pkarcsi55/AI-Assisted-Evaluation-of-Detector-Outputs/Schematic_DETECTOR_2025-05-02.pdf

# LOLIN-Lite-ESP32 Bat+ 27 Bat- 28

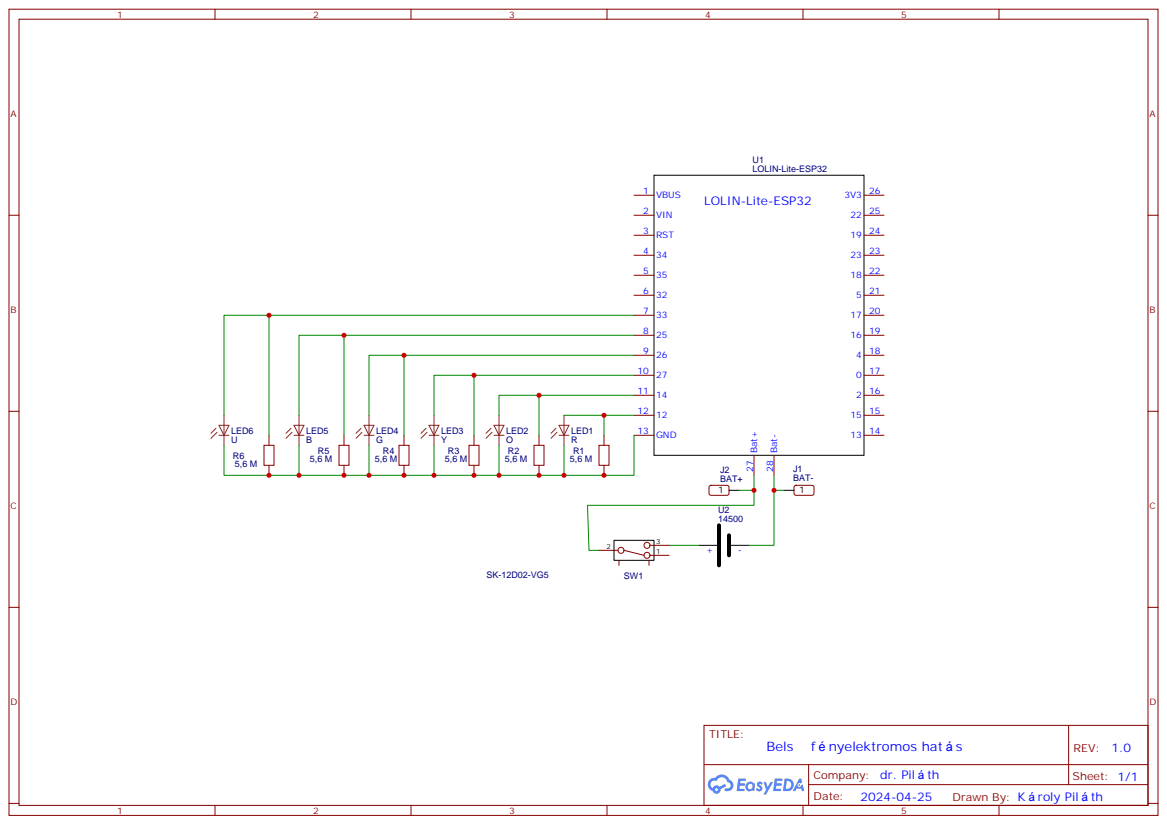
[picture p5: page 1]

Company: dr. Pil th

Drawn By: K roly Pil th
